erdmannp/vw-t5-thermometer/README.md

# vw-t5-thermometer
Integrates a thermometer (inside and outside) into an old VW T5 dashboard
