erdmannp/vw-t5-thermometer/solvespace/t5_thermometer.step

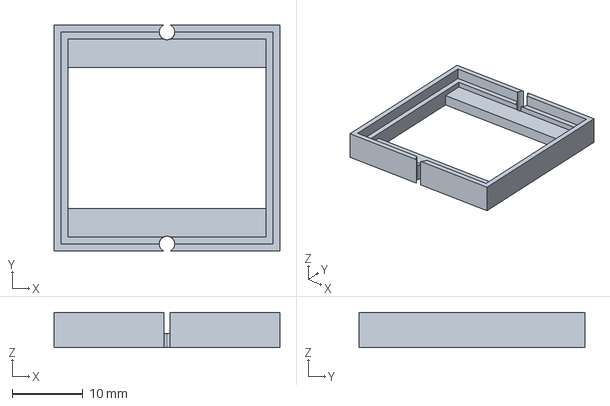
[picture p1: CAD file, 2024-10-22]
solvespace/t5_thermometer.step
32.0 x 32.0 x 5.00 mm
