erdmannp/vw-t5-thermometer/kicad/t5_thermometer/t5_thermometer.kicad_pcb

## KiCad design kicad/t5_thermometer/t5_thermometer.kicad_pcb (2024-10-27)

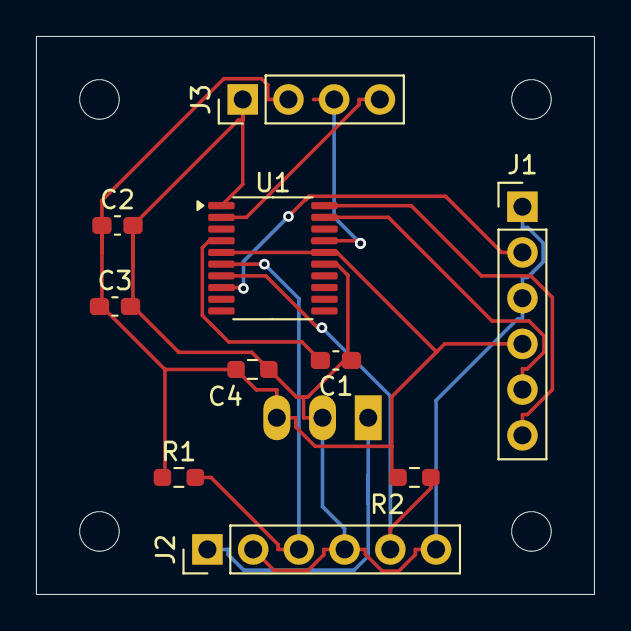
[picture p2: board t5_thermometer.kicad_pcb from above]

Board: 2 copper layers, 31.0 x 31.0 mm, 15 parts (1 on the bottom side), 11 nets.

Parts:
C1, C2: 100n; C_0603_1608Metric_Pad1.08x0.95mm_HandSolder
C3: 4,7u; C_0603_1608Metric_Pad1.08x0.95mm_HandSolder
C4: 22n; R_0603_1608Metric_Pad0.98x0.95mm_HandSolder
H1, H2, H3, H4: MountingHole_Pad; MountingHole_2.2mm_M2
J1: DBG; PinHeader_1x06_P2.54mm_Vertical
J2: PinHeader_1x06_P2.54mm_Vertical
J3: Display; PinHeader_1x04_P2.54mm_Vertical
R1, R2: R10k; R_0603_1608Metric_Pad0.98x0.95mm_HandSolder
U1: STM32F042F6Px; TSSOP-20_4.4x6.5mm_P0.65mm
U2: TSR_1-2433; Converter_DCDC_TRACO_TSR-1_THT

Connections:
+3.3V: C2.1, C3.1, C4.2, J1.4, J3.2, R1.1, R2.2, U1.5 (VDDA), U1.16 (VDD), U2.3 (Vout)
/ADC_INDOOR: J2.3, R1.2, U1.6 (PA0)
/ADC_OUTDOOR: J2.5, R2.1, U1.7 (PA1)
/I2C_SCL_DISPLAY: J3.3, U1.17 (PA9/PA11)
/I2C_SDA_DISPLAY: J3.4, U1.2 (PF0)
/SYS_SWCLK: J1.6, U1.20 (PA14)
/SYS_SWDIO: J1.5, U1.19 (PA13)
/USART2_TX_DBG: J1.2, U1.8 (PA2)
GND: C1.1, C2.2, C3.2, C4.1, J1.1, J1.3, J2.2, J2.4, J2.6, J3.1, U1.1 (PB8), U1.15 (VSS), U2.2 (GND)
unnamed: J2.1, U2.1 (Vin)
unnamed: C1.2, U1.4 (NRST)
