erdmannp/vw-t5-thermometer/(commit log)

2024-10-19 Configure all necessary Pins, I2C DMA is missing
    [t5_thermometer.kicad_pcb, t5_thermometer.kicad_sch]
2024-10-20 Add 3D Model for VW T5
    [t5_thermometer.step]
2024-10-20 Add configuration and PCB design which was ordered.
    [t5_thermometer.kicad_pcb, t5_thermometer.kicad_sch]
2024-10-22 Add new 3d model, add font generator and fonts
    [t5_thermometer.step]
2024-10-26 schematic change: - Add 4,7k pull up for I2C - Connect PB8 to GND. PB8 was initially planned as I2C SCL, but due to the fact that it also operates as BOOT0 pin, it cannot be pulled up.
    [t5_thermometer.kicad_pcb, t5_thermometer.kicad_sch]
2024-10-27 free PB8 pin, fix several issues, add configurability to ssd1306 lib
    [t5_thermometer.kicad_sch]
2024-10-27 Change Layout to match the current working status: BOOT0 is now connected to GND
    [t5_thermometer.kicad_pcb, t5_thermometer.kicad_sch]
2024-10-28 Finalizing.
    - Adding DMA and ADC
    - Check temperature every 500 ms.
